Lameguy64/LameMouseConverter/Basic Schematic.sch

## KiCad design Basic Schematic.sch (2022-04-13)

Schematic: Basic Schematic.sch

Parts:
A1: Arduino_UNO_R3
C1, C3, C4, C5: 16v 1uf
C2: 100pf
J1: PS2_MOUSE
J2: DB9_Female
JP1: RX_EN
JP2: RTS_EN
JP3: AUTOBAUD
U1: MAX232

Notes on the sheet:
JP1=O JP2=S: Mouse Systems/Microsoft JP1=S JP2=O: Mouse Systems/C7
