Lameguy64/LameMouseConverter/(threads)

Thread 1 (2021-09-07):

Extended command '*?' not yet supported

Lameguy64, 2021-09-07:
Logitech's MouseWare drivers (MOUSE.COM/LMOUSE.COM) issues a extended command '*?' to identify a C model mouse otherwise it just identifies the mouse converter as an ordinary 2 button Microsoft mouse without configuration features. The command is not documented anywhere and extended commands are not supported on Logitech PS/2 mice that can be adapted to serial with a passive adapter, so it'll take awhile until I get a C model mouse (ie. a Logimouse C7) and probe the command myself.

Thread 2 (2022-10-15):

Cannot upload "LMC.hex" to Arduino UNO/NANO without getting config error message on Windows 10 using avrdude

dekkit, 2022-10-15:
Many thanks to Lameguy64 for releasing this project!

Just to share in case anyone else is trying to build this on **Windows 10** and receiving errors when using avrdude - as i found a work around that may assist anyone else building this.

Firstly, avrdude was be found in the following folder for me:
C:\Program Files (x86)\Arduino\hardware\tools\avr\bin>

I used the command line: avrdude -patmega328p -carduino -D -P COM5 -U flash:w:LMC.hex:i
(note the flash image name has changed from what is documented the README.TXT to now "LMC.hex" and my Arduino was on COM 5):

I copied LMC.hex into the same folder as arvdude.

When running the command to upload the .hex file, I received errors (ie avrdude: can't open config file something similar).  It appears that avrdude is looking for a avrdude.conf but cannot find it (its stored in "C:\Program Files (x86)\Arduino\hardware\tools\avr\etc" on my install).

The quick most simplest workaround once you've found where avrdude.conf is stored is just temporarily copy it into the same folder as avrdude
ie
**FROM** C:\Program Files (x86)\Arduino\hardware\tools\avr\etc
**TO** "C:\Program Files (x86)\Arduino\hardware\tools\avr\bin

or alternatively you can amend the command line above where it mentions "-carduino" to specify the correct folder path.
