Lameguy64/LameMouseConverter/(commit log)

2022-01-21 Added SummaMouse MM Series protocol, fixed init failure with older Microsoft PS/2 Mice
    [PS2SER2.ASM]
2022-04-13 Now C-model compatible, rewrote README, fixed SummaMouse format, optimized assembler code, and included pre-assembled HEX file for convenience
    [Basic Schematic.sch]
2022-04-24 Fixed typo in CAPTO8 macro
    [PS2SER2.ASM]
2022-05-21 Implemented quadrature mouse simulation and watchdog timer reset
    [LMC.ASM]
